fm-futura/dtmf-remote-sequencer/README.md

# Remote power sequencer

This is a very simple device to power on or off the transmitter from our
studio using DTMF tones.
