fm-futura/dtmf-remote-sequencer/hardware/remote-sequencer.kicad_pcb

## KiCad design hardware/remote-sequencer.kicad_pcb (2018-12-27)

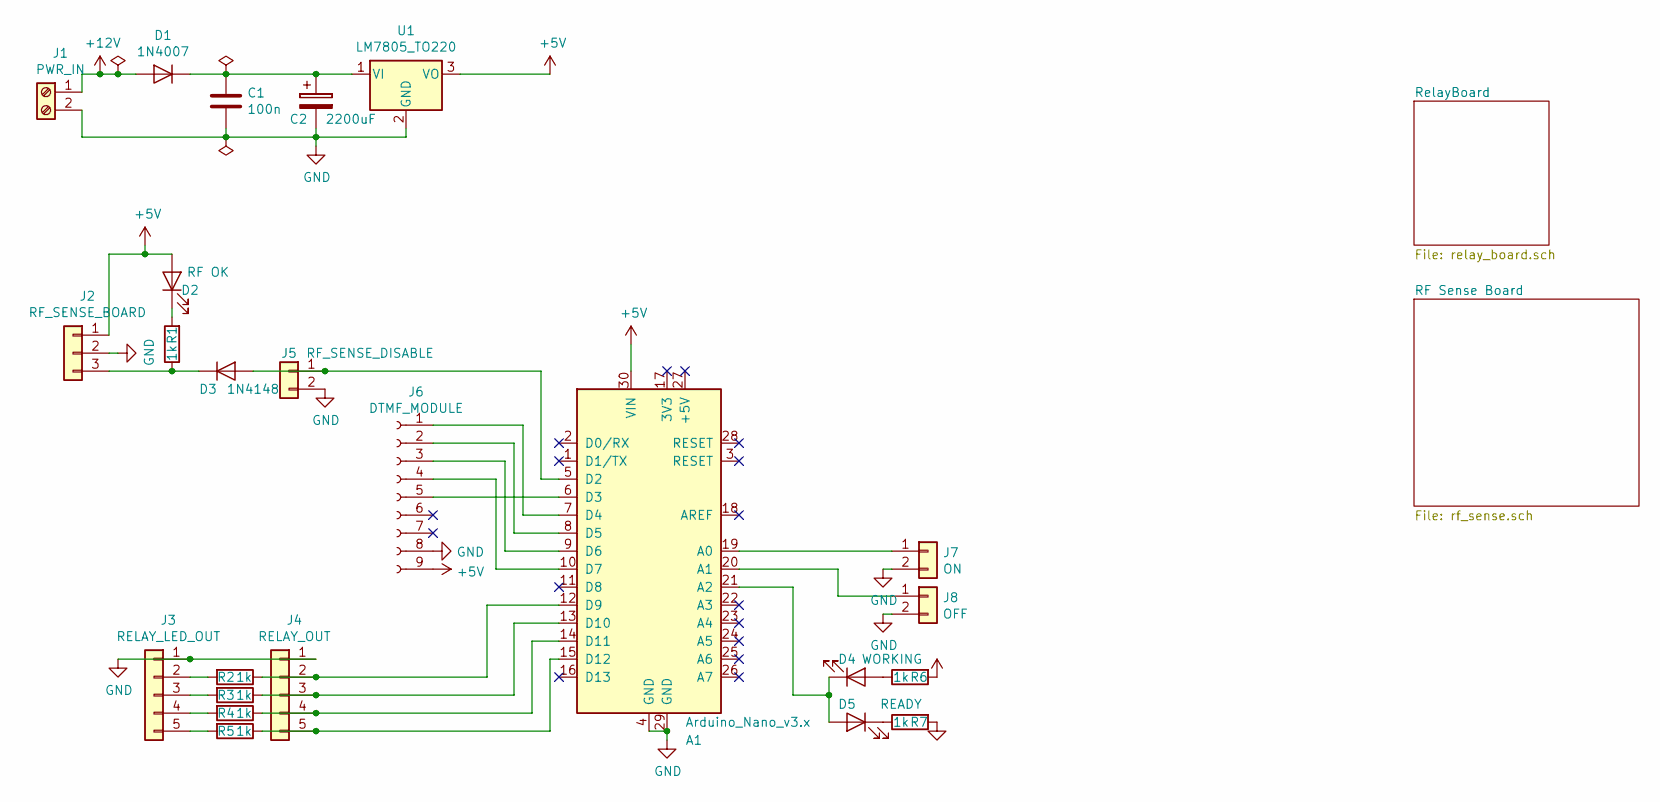
[picture p1: schematic remote-sequencer.sch, Main board]

Parts:
A1: Arduino_Nano_v3.x; Arduino_Nano_WithMountingHoles
C1: 100n; C_Disc_D4.7mm_W2.5mm_P5.00mm
C2: 2200uF; CP_Radial_D8.0mm_P5.00mm
D1: 1N4007; D_DO-41_SOD81_P10.16mm_Horizontal
D2: RF OK; Socket_Strip_Straight_1x02_Pitch2.54mm
D3: 1N4148; D_DO-41_SOD81_P10.16mm_Horizontal
D4: WORKING; Socket_Strip_Straight_1x02_Pitch2.54mm
D5: READY; Socket_Strip_Straight_1x02_Pitch2.54mm
J1: PWR_IN; TerminalBlock_bornier-2_P5.08mm
J2: RF_SENSE_BOARD; Pin_Header_Straight_1x03_Pitch2.54mm
J3: RELAY_LED_OUT; Socket_Strip_Straight_1x05_Pitch2.54mm
J4: RELAY_OUT; Socket_Strip_Straight_1x05_Pitch2.54mm
J5: RF_SENSE_DISABLE; Socket_Strip_Straight_1x02_Pitch2.54mm
J6: DTMF_MODULE; SIP9_Housing_BigPads
J7: ON; Socket_Strip_Straight_1x02_Pitch2.54mm
J8: OFF; Socket_Strip_Straight_1x02_Pitch2.54mm
R1, R2, R3, R4, R5, R6, R7: 1k; R_Axial_DIN0204_L3.6mm_D1.6mm_P5.08mm_Horizontal
U1: LM7805_TO220; TO-220-3_Vertical

Connections:
+5V: A1.30 (VIN), D2.2 (A), J2.1, J6.9, R6.2, U1.3 (VO); also elsewhere on the board
+12V: D1.2 (A), J1.1; also elsewhere on the board
GND: A1.4 (GND), A1.29 (GND), C1.2, C2.2, J1.2, J2.2, J3.1, J4.1, J5.2, J6.8, J7.2, J8.2, R7.2, U1.2 (GND); also elsewhere on the board
unnamed: A1.5 (D2), D3.2 (A), J5.1
unnamed: A1.6 (D3), J6.5
unnamed: A1.7 (D4), J6.1
unnamed: A1.8 (D5), J6.2
unnamed: A1.9 (D6), J6.3
unnamed: A1.10 (D7), J6.4
unnamed: A1.12 (D9), J4.2, R2.1
unnamed: A1.13 (D10), J4.3, R3.1
unnamed: A1.14 (D11), J4.4, R4.1
unnamed: A1.15 (D12), J4.5, R5.1
unnamed: A1.19 (A0), J7.1
unnamed: A1.20 (A1), J8.1
unnamed: A1.21 (A2), D4.1 (K), D5.2 (A)
unnamed: C1.1, C2.1, D1.1 (K), U1.1 (VI)
unnamed: D2.1 (K), R1.2
unnamed: D3.1 (K), J2.3, R1.1
unnamed: D4.2 (A), R6.1
unnamed: D5.1 (K), R7.1
unnamed: J3.2, R2.2
unnamed: J3.3, R3.2
unnamed: J3.4, R4.2
unnamed: J3.5, R5.2

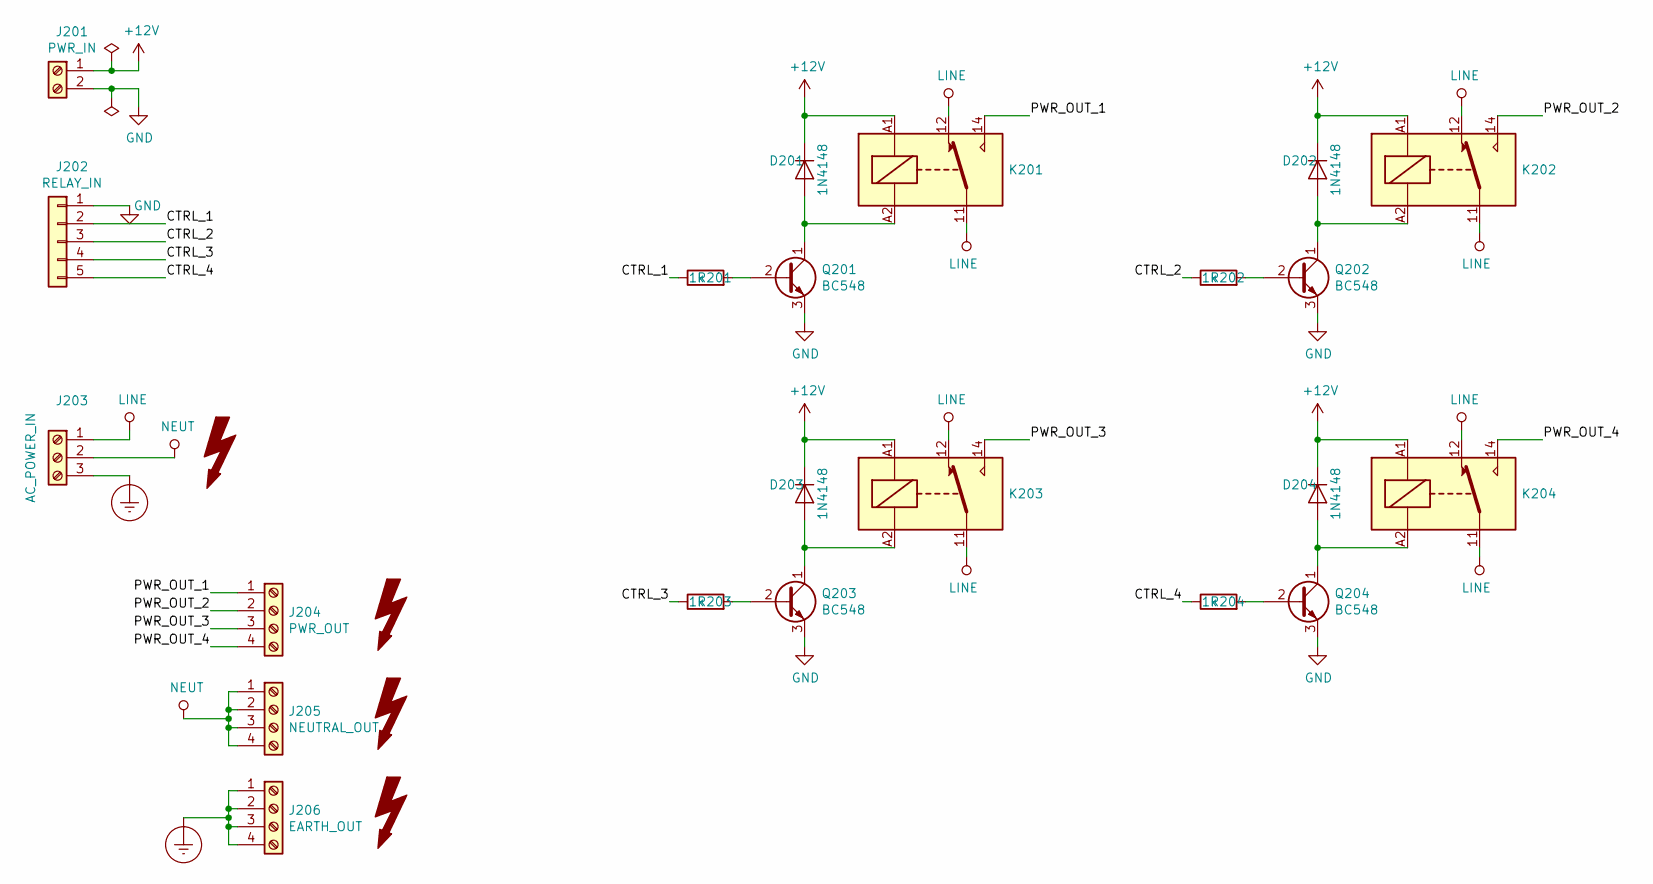
[picture p2: schematic relay_board.sch, Relay Board]

Parts:
D201, D202, D203, D204: 1N4148; D_DO-41_SOD81_P10.16mm_Horizontal
J201: PWR_IN; TerminalBlock_bornier-2_P5.08mm
J202: RELAY_IN; Socket_Strip_Straight_1x05_Pitch2.54mm
J203: AC_POWER_IN; TerminalBlock_bornier-3_P5.08mm
J204: PWR_OUT; TerminalBlock_bornier-4_P5.08mm
J205: NEUTRAL_OUT; TerminalBlock_bornier-4_P5.08mm
J206: EARTH_OUT; TerminalBlock_bornier-4_P5.08mm
K201, K202, K203, K204: RELAY_DPDT; Relay_SPDT_Schrack-RP-II-1-16A-FormC_RM5mm
Q201, Q202, Q203, Q204: BC548; TO-92_Rugged
R201, R202, R203, R204: 1k; R_Axial_DIN0204_L3.6mm_D1.6mm_P5.08mm_Horizontal

Connections:
+12V: D201.1 (K), D202.1 (K), D203.1 (K), D204.1 (K), J201.1, K201.A1, K202.A1, K203.A1, K204.A1; also elsewhere on the board
/RelayBoard/CTRL_1: J202.2, R201.1
/RelayBoard/CTRL_2: J202.3, R202.1
/RelayBoard/CTRL_3: J202.4, R203.1
/RelayBoard/CTRL_4: J202.5, R204.1
/RelayBoard/PWR_OUT_1: J204.1, K201.14
/RelayBoard/PWR_OUT_2: J204.2, K202.14
/RelayBoard/PWR_OUT_3: J204.3, K203.14
/RelayBoard/PWR_OUT_4: J204.4, K204.14
Earth_Protective: J203.3, J206.1, J206.2, J206.3, J206.4
GND: J201.2, J202.1, Q201.3 (E), Q202.3 (E), Q203.3 (E), Q204.3 (E); also elsewhere on the board
LINE: J203.1, K201.11, K201.12, K202.11, K202.12, K203.11, K203.12, K204.11, K204.12
NEUT: J203.2, J205.1, J205.2, J205.3, J205.4
unnamed: D201.2 (A), K201.A2, Q201.1 (C)
unnamed: D202.2 (A), K202.A2, Q202.1 (C)
unnamed: D203.2 (A), K203.A2, Q203.1 (C)
unnamed: D204.2 (A), K204.A2, Q204.1 (C)
unnamed: Q201.2 (B), R201.2
unnamed: Q202.2 (B), R202.2
unnamed: Q203.2 (B), R203.2
unnamed: Q204.2 (B), R204.2

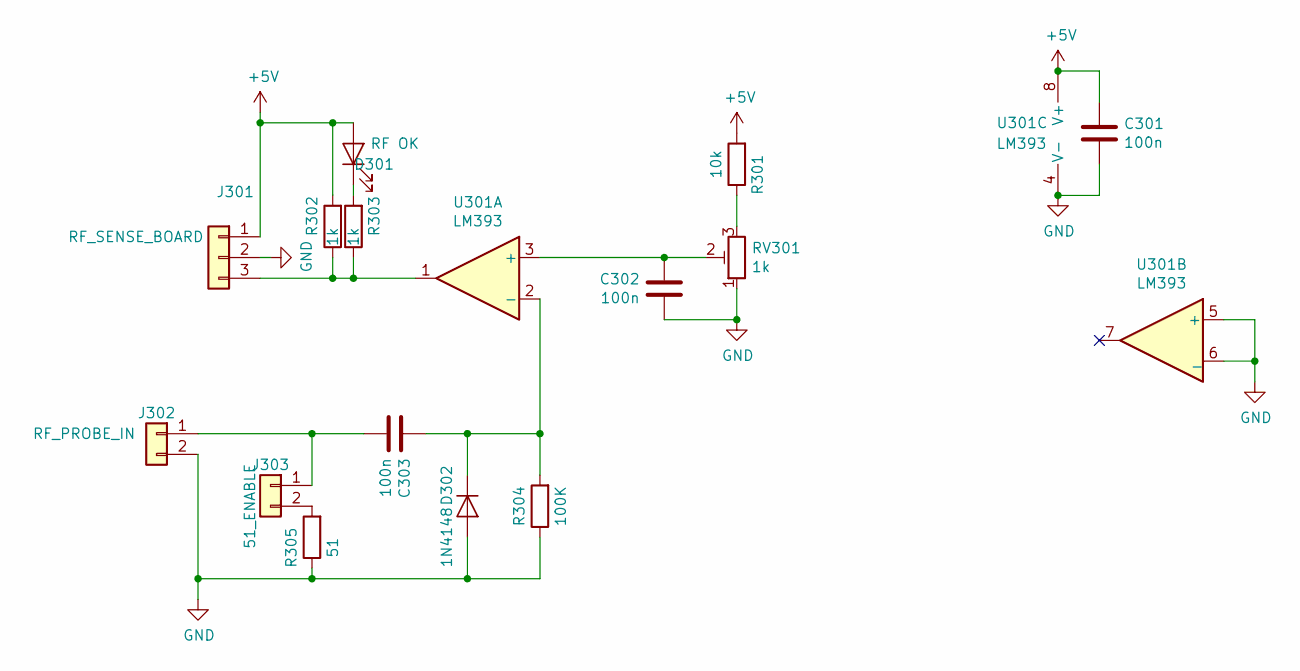
[picture p3: schematic rf_sense.sch]

Parts:
C301, C302, C303: 100n; C_Disc_D4.7mm_W2.5mm_P5.00mm
D301: RF OK; Socket_Strip_Straight_1x02_Pitch2.54mm
D302: 1N4148; D_DO-41_SOD81_P2.54mm_Vertical_AnodeUp
J301: RF_SENSE_BOARD; Pin_Header_Straight_1x03_Pitch2.54mm
J302: RF_PROBE_IN; Socket_Strip_Straight_1x02_Pitch2.54mm
J303: 51_ENABLE; Socket_Strip_Straight_1x02_Pitch2.54mm
R301: 10k; R_Axial_DIN0204_L3.6mm_D1.6mm_P5.08mm_Horizontal
R302, R303: 1k; R_Axial_DIN0204_L3.6mm_D1.6mm_P5.08mm_Horizontal
R304: 100K; R_Axial_DIN0204_L3.6mm_D1.6mm_P5.08mm_Horizontal
R305: 51; R_Axial_DIN0204_L3.6mm_D1.6mm_P5.08mm_Horizontal
RV301: 1k; Potentiometer_Trimmer_Bourns_3006P
U301: LM393; DIP-8_W7.62mm_Socket_LongPads

Connections:
+5V: C301.1, D301.2 (A), J301.1, R301.2, R302.2, U301.8 (V+); also elsewhere on the board
GND: C301.2, C302.2, D302.2 (A), J301.2, J302.2, R304.1, R305.1, RV301.1, U301.4 (V-), U301.5 (+), U301.6 (_); also elsewhere on the board
unnamed: C302.1, RV301.2, U301.3 (+)
unnamed: C303.1, D302.1 (K), R304.2, U301.2 (-)
unnamed: C303.2, J302.1, J303.1
unnamed: D301.1 (K), R303.2
unnamed: J301.3, R302.1, R303.1, U301.1
unnamed: J303.2, R305.2
unnamed: R301.1, RV301.3

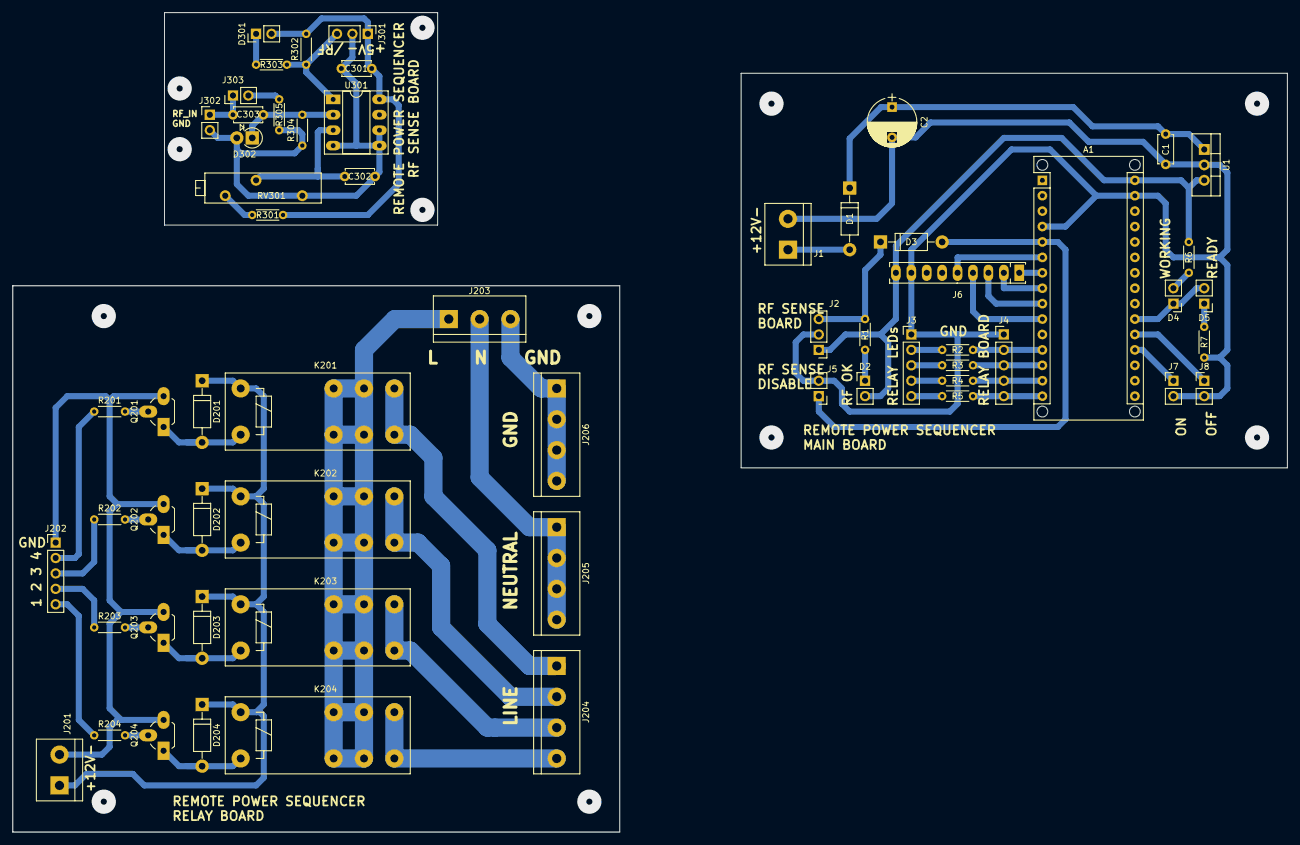
[picture p4: board remote-sequencer.kicad_pcb from above]

Board: 2 copper layers, 210.0 x 135.0 mm, 61 parts (0 on the bottom side), 51 nets.
