fm-futura/dtmf-remote-sequencer/(commit log)

2018-12-18 fix overflow when comparing times
    [remote.ino]
2018-12-18 increase power ok delay
2018-12-19 limit the amount of auto resets
    [remote.ino]
2018-12-19 do nothing if the requested power state matches current state
2018-12-19 adds current state output
2018-12-22 adds main board design files
    [remote-sequencer.kicad_pcb, remote-sequencer.sch]
2018-12-22 adds relay board schematic and pcb
    [relay_board.sch, remote-sequencer.kicad_pcb, remote-sequencer.sch]
2018-12-27 adds rf sense board schematic and pcb
    [relay_board.sch, remote-sequencer.kicad_pcb, remote-sequencer.sch, rf_sense.sch]
2018-12-27 update output preferences
    [remote-sequencer.kicad_pcb]
2019-01-13 enable interrupt after power on sequence
    There was a very small chance of having an interrupt firing while we
    were powering on and state was set to IDLE (erroneously)
2019-01-13 factor out state led updating, set on first power up
2019-01-13 adds schematics and boards as svg files
